primo-io/prototype-documentation/languages/brazilianportuguese.md

---
layout: default
title: Documentação protótipo Cubetto
language: Português Brasileiro
category: language
---

<br>

<div id="content" markdown="1">
##0. O que é esse documento

primo play set
Este documento reúne todas as informações necessárias para construir um protótipo do Primo.
Você pode achar mais informações sobre o projeto no site [primo.io](http://primo.io).

<h2>
<a href="#" id="translate-title">
    Como traduzir esse documento
</a>
</h2>

<div markdown="1" id="translate">

Se você gostaria de traduzir essa página para outra língua, você tem algumas opções:

1. **super fácil, sem automações** Copie e cole essa página em seu editor de texto, traduza-a e então nos envie um email para [play@primo.io](mailto:play@primo.io)

2. **fácil, um pouquinho mais automático** Crie uma conta no [GitHub](http://github.com), então abra o [repositório dessa página]https://github.com/primo-io/prototype-documentation/blob/gh-pages/index.md) e clique em 'EDIT' na barra de menus superior:

Sua página se tornará um editor de textos, onde será possível modificar a página original. A página está escrita em [markdown](http://daringfireball.net/projects/markdown/syntax), uma linguagem super fácil de entender.

Você não tem que modificar o código, apenas copie e cole em seu editor de texto local e traduza a parte textual em sua língua, sem modificar os parênteses e as partes em HTML. Salve o texto e então nos envie um email para [play@primo.io](mailto:play@primo.io)

3. **avançado, tudo automático** Essa opção é um pouco mais avançada, mas nada tão difícil assim, se você não é familiarizado com o Github essa é a chance de aprender algo novo :) <br>
Se você já conhece o Git, você deve dar um 'fork' no repositório, todas as traduções estão localizadas na pasta 'languages’. Para traduzir esse documento, apenas copie uma das páginas com a tradução inicial (“english.md” por exemplo) na mesma pasta e então mude o nome do arquivo para o nome da língua que você está traduzindo (spanish.md). Mude os valores 'title' (título na sua língua) e 'language' (a linguagem final, com Letras Maiúsculas) e depois traduza o restante do documento. Uma vez terminada a tradução, faça uma requisição pelo Git (‘pull request‘) para adicionar o seu novo arquivo à pasta original. Ele será automaticamente adicionado ao menu.<br><br>
Segue abaixo um passo-a-passo:

  1. Crie uma conta no GitHub
  2. Faça o download do aplicativo GitHub para desktop ([Mac](http://mac.github.com/), [Windows](http://windows.github.com/))
  3. Se é a primeira vez que você o utiliza, abra o programa e entre com o login e senha de sua conta no GitHub
  4. Vá para [esse repositório](https://github.com/primo-io/prototype-documentation)
  5. Clique no botão ‘Fork‘ no canto superior direito, para trabalhar em paralelo com esses arquivos dentro de sua conta.
  6. Vá para sua conta no GitHub, abra a página do repositório que você acabou de dar um ‘fork‘ e clique no botão "Clone in Desktop", na barra lateral direita. Isso fará com o que o aplicativo do GitHub abra automaticamente, perguntando onde salvar o repositório em seu disco local.
  7. Depois de selecionar um local em seu computador, clique em 'clone'
  8. Depois de fazer o download dos arquivos, entre na pasta onde os arquivos foram baixados em seu computador.
  9. Abra a pasta 'languages', onde todas as traduções estão localizadas. Selecione a língua com que você vai começar ("english.md" por exemplo), e então copie o arquivo e renomeie-o com o nome da língua de destino ("spanish.md" por exemplo), na mesma pasta.
  10. Abra o arquivo recém-criado e mude os valores 'title' (título na nova língua) e 'language' (a língua de destino em Letras Maiúsculas), então traduza o documento, mantendo a formatação markdown.
  11. Depois de terminada e salva a tradução é hora de subir o arquivo para o GitHub. Abra o aplicativo do GitHub e clique duas vezes no repositório. Na barra lateral esquerda, clique na aba "Changes". Ela deve informar "Uncommitted Changes".
  12. Dê um título à sua edição, como "spanish translation", clique em "commit" e depois no botão "sync".
  13. Vá até o seu perfil no GitHub, na página do repositório que você trabalhou em paralelo (“forked”). Você deve ser capaz de ver a nova página criada na pasta 'languages'. Na parte superior deve haver um botão verde com duas setas, clique nele para requisitar a publicação. (veja a figura abaixo)

  

  14. Clique em "Create Pull Request"
	
  

  15. Escreva uma mensagem para a sua requisição e é só isso! Agora nós apenas precisamos aprová-la.
</div>
<br>

##1. O que é o Primo

primo play set

Primo é uma interface física projetada para introduzir a lógica de programação para crianças pequenas (de 3 a 7 anos), sem a necessidade de alfabetização. O objetivo do jogo é conduzir um pequeno robô, chamado Cubetto, de volta para sua casa. Para alcançar o objetivo, as crianças devem programar o robô usando um conjunto limitado de instruções: em frente, à esquerda, à direita e função. Enquanto as primeiras três instruções são bem intuitivas, essa última chama uma sub-rotina, uma linha extra de instruções empacotadas em um único comando.

<div class="videoWrapper">
	<iframe src="//player.vimeo.com/video/82620072" frameborder="0" webkitallowfullscreen="true" mozallowfullscreen="true"  allowfullscreen="true">        
    </iframe> 
</div>

##2. Pesquisa

O ensino de programação para crianças é um campo já amplamente debatido. Nós já conhecemos algumas soluções que possuem esse mesmo objetivo, mas para crianças acima de 8 anos. Entretanto, não existem muitas soluções adaptadas para crianças mais novas e não existe nenhuma que trabalha sem a necessidade de telas e de pré-alfabetização. Vemos um número crescente de aplicativos para tablets e computadores que também trabalham em conjunto com robôs, mas nenhum deles é completamente livre do domínio do pixel como é o nosso conjunto Primo.

A madeira foi escolhida como o material principal, em primeiro lugar, porque é natural; traz uma sensação mais 'quente' e tem uma sonoridade bacana. A segunda razão é cultural. Foram realizadas pesquisas sobre brinquedos utilizados em jardins de infância tradicionais na Suíça (onde o produto foi originalmente concebido) e foi descoberto que os jogos mais queridos pelas crianças eram aqueles feito com madeira. Brinquedos de madeira são, de maneira geral, muito duráveis e você pode ver as marcas e arranhões neles, sinais de seu uso por outras crianças. É um material com memória. A madeira foi escolhida também como material por conta do forte contraste que ela cria com o uso da tecnologia. Dentro do Primo existe um circuito integrado, mas nós queríamos criar uma experiência 'mágica', escondendo propositadamente a complexidade existente no conjunto.



O conceito por detrás do Primo é muito inspirado pelo trabalho de Seymour Papert, um matemático que foi o co-fundador do Laboratório de Inteligência Artificial no MIT, juntamente com Marvin Minsky nos anos sessenta (se você está interessado nesse tema, sugerimos que você leia [Mindstorms](http://www.amazon.co.uk/Mindstorms-Children-Computers-Powerful-Ideas/dp/0465046746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), seu livro mais famoso). Ele dirigia a equipe que inventou o [LOGO](http://en.wikipedia.org/wiki/Logo_(programming_language)), provavelmente o recurso mais amplamente utilizado para o ensino de programação para crianças. O objetivo de Seymour Papert não era apenas ensinar a programar, mas também ajudar as crianças a descobrir a sua maneira pessoal de resolver problemas. Primo pode ser considerado uma grande simplificação do LOGO e da 'tartaruga', que era a sua interface física. Nós limitamos as nossas instruções à sua mais pura forma, evitando qualquer tipo de linguagem numérica ou textual.

O primeiro protótipo do Primo foi realizado no SUPSI Lugano, por Matteo Loglio (co-fundador do Primo e designer de interação), durante o [MAInD - Master of Advanced Studies in Interaction Design](http://www.maind.supsi.ch/). A formação de Matteo é em design do produto e depois de aprender o básico sobre Arduino e sua programação, suficientes para a criação do protótipo, ele começou a procurar por soluções técnicas que eram acessíveis para um novato, com o intuito de desenvolver um produto como o Primo. Existiam dois problemas principais: a execução de um carro-robô desde o zero e uma interface que pudesse reconhecer facilmente diferentes instruções.
O primeiro problema foi resolvido com o uso de uma placa [Oh_Oh board](http://david.cuartielles.com/w/Maquila2/Ohoh) de  David Cuartielles, um dos fundadores do Arduino, que havia dado uma palestra no SUPSI. O Oh_Oh robot é um projeto Open Source - de código aberto - e você pode acessar os arquivos fonte no link acima. É basicamente um Arduino em forma de carro, apenas com um Xbee adicionado para a comunicação via radio.

A segunda questão era projetar uma maneira confiável de detectar os blocos de instrução. A solução foi inspirada por um projeto do [CIID](http://ciid.dk/) chamado ["Barcode Piano"](http://ciid.dk/education/portfolio/idp11/courses/physical-computing/projects/barcode-piano/). 

<div class="videoWrapper">
	<iframe src="//player.vimeo.com/video/19704918" frameborder="0" webkitallowfullscreen="true" mozallowfullscreen="true"  allowfullscreen="true">    
    </iframe>
</div> 

A idéia era usar blocos bem simples, que poderiam ser reconhecidos pela placa usando resistores. É uma operação básica de divisão de voltagem, com os pinos analógicos do Arduino lendo os valores dos resistores. É um método bem simples mas bastante eficiente para um protótipo.

No campo do design, algumas características ainda precisavam ser testadas; o design atual é o resultado de muitas iterações.

O a escolha do formato de 'cobra' ou ‘zig-zag' para a sequência de instruções foi escolhida para evitar pré-concepções relacionadas com a alfabetização.  

left to right

O formato em 'D' dos blocos conectores foi projetado para que os mesmos pudessem ser inseridos de uma só maneira, sendo consistentes com o desenho do caminho e com a direção a ser seguida pelo carro. Múltiplos designs poderiam ser usados para isso. O formato em D foi escolhido pois é basicamente 'um circulo com orientação' e também porque de certa maneira remete a um quadro de avisos, um objeto familiar.

instruction blocks

O desenho do formato dos blocos de instrução ainda está sendo testado. O design atual funciona bem, as crianças pegam facilmente o significado. Eles apenas tem alguma dificuldade inicial para se familiarizarem com os blocos de comando ‘direita' e ‘esquerda’. Isso ocorre também porque, em geral, esses conceitos de direção também são novos para os pequenos. Continuamos testando outros formatos de blocos para aprimorar ainda mais essa questão.

<div class="videoWrapper">
	<iframe src="//player.vimeo.com/video/50570097" frameborder="0" webkitallowfullscreen="true" mozallowfullscreen="true"  allowfullscreen="true">
        
    </iframe>
</div>

No início, o robô tinha a forma de um carrinho de brinquedo e era uma forma bem complicada, que consumia um tempo enorme para ser produzida, pois era toda cortada à laser, colada camada por camada e depois lixada por mais de uma hora. O carro também continha um outro problema, que era ser muito orientado para meninos. Queríamos evitar a discussão com os produtores de brinquedos educativos e sermos criticados por fazermos apenas brinquedos para meninos. Queríamos nos manter neutros e não criar um brinquedo específico para meninos ou meninas, então optamos por uma geometria super neutra, uma caixa.

Demos um nome para a caixinha, junto com uma carinha sorridente, fazendo-o mais chamativo para as crianças. O robô foi chamado de Cubetto (cubinho em italiano). A idéia com o Cubetto é também criar um módulo básico que pode ser expandido e customizado facilmente no futuro.

cubetto

##3. Começando

###3.1 O básico

Primo é composto por três partes: a Mesa de Interface, o Cubetto e um conjunto de Blocos de Instrução. As crianças interagem com a Mesa colocando os Blocos de Instrução nos orifícios para criar uma seqüência (Um programa) que o Cubetto vai executar.

Existem quatro tipos de Blocos de Instrução, o que significa que resistores com 4 valores distintos podem ser usados, preferencialmente com valores distantes uns dos outros.

Os Blocos são inseridos nos orifícios da Mesa de Interface, onde o valor do resistor é identificado. Depois disso, os valores são processados em uma ‘fila’, que é enviada ao Cubetto usando dois módulos Xbee. Então o Cubetto executa as instruções, uma após a outra.

O cérebro do protótipo é feito com duas placas Arduino, uma UNO (uma Leonardo ou uma Duemilanove também funcionam) para o Cubetto e uma Mega para a Mesa de Interface, onde são necessárias 16 entradas analógicas.

###3.2 Eletrônica

###Ferramentas Necessárias

* Ferro de solda
* Solda
* Fios
* Pistola de cola quente
* Cola de madeira
* Fita de cobre com 5mm de largura

###Materiais (preços em euro)

Cubetto ~ 88 €

* Arduino UNO (ou Leonardo) - 20 € : [Arduino Store](http://store.arduino.cc/index.php?main_page=product_info&cPath=11&products_id=195#.UxC5nfTV_bA)
* Módulo Arduino Proto Wireless Shield - 14.90 € : [Arduino Store](http://store.arduino.cc/index.php?main_page=product_info&cPath=37_5&products_id=145#.UxC53vTV_bA)
* Driver para Motor SN754410 - 3.90 € : [Arduino Store](http://store.arduino.cc/index.php?main_page=product_info&cPath=6_33&products_id=153#.UxC5-_TV_bB)
* XBee (série 1 ou 2, não faz diferença) : 23.90 € - [Arduino Store](http://store.arduino.cc/index.php?main_page=product_info&cPath=37_38&products_id=292#.UxC6cvTV_bA)
* Rodas SolarBotics  x 2 : 4.74 € - [Solarbotics Store](https://solarbotics.com/product/gmpw/)
* Motores GM3 SolarBotics x 2 : 8.36 € - [Solarbotics Store](https://solarbotics.com/product/gm3/)
* 2 rodizios de metal : 5.79 € - [Solarbotics Store](https://solarbotics.com/product/23160/)
* Interruptor óptico refletivo CNY70 x 2 : 1 € - [Mouser](http://uk.mouser.com/ProductDetail/Vishay/CNY70/?qs=%2fha2pyFaduj8YpDhNNtXszq4w32cl%2fAjUjdOwQUvJUM%3d)
* (opcional) Suporte de bateria : 4 € - [Solarbotics Store](https://solarbotics.com/product/bholdaa_4_cell/)
* (opcional) 4 x Baterias recarregáveis

Mesa de Interface ~ 88 € (pura coincidência)

* Arduino Mega 2560 : 39.00 € - [Arduino Store](http://store.arduino.cc/index.php?main_page=product_info&cPath=11&products_id=196#.UxC_gPTV_bA)
* Módulo Arduino Proto Wireless Shield : 14.90 - [Arduino Store](http://store.arduino.cc/index.php?main_page=product_info&cPath=37_5&products_id=145#.UxC53vTV_bA)
* XBee (série 1 ou 2, não faz diferença) : 23.90 € - [Arduino Store](http://store.arduino.cc/index.php?main_page=product_info&cPath=37_38&products_id=292#.UxC6cvTV_bA)
* 16 LEDs 5mm Vermelho : 1 € - [Mouser](http://uk.mouser.com/ProductDetail/Lite-On/LTL-4223/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)
* 16 Resistores 220 Ω  : 0.16 € - [Mouser](http://uk.mouser.com/ProductDetail/Xicon/291-220-RC/?qs=sGAEpiMZZMu61qfTUdNhG%2f1uGo5nxyCVqn6ChOCvUEE%3d)
* 16 Resistores 10K Ω : 0.16 € - [Mouser](http://uk.mouser.com/ProductDetail/Xicon/291-10K-RC/?qs=sGAEpiMZZMu61qfTUdNhG6xwTrVwTvbz8PPav3aExs8%3d)
* 1 Chave tipo Push Button NA sem trava : 1 € 
* 50 Conectores macho simples : 1 € 
* 16 Conectores macho duplos : 0.50 € - [Arduino Store](http://store.arduino.cc/index.php?main_page=product_info&cPath=6_32&products_id=294#.UxC_3fTV_bA)
* 50 Conectores fêmea : 1 € - [Arduino Store](http://store.arduino.cc/index.php?main_page=product_info&cPath=6_32&products_id=188#.UxDAAfTV_bA)
* 16 Imãs ø 4 h 3 : 3.5 € - [Supermagnete](http://www.supermagnete.ch/eng/S-04-03-N)

Blocos de Instrução ~ 4 €

* 4 x Resistor 4.7K Ω : 0.04 € - [Mouser](http://uk.mouser.com/ProductDetail/Xicon/291-47K-RC/?qs=sGAEpiMZZMu61qfTUdNhG%2fbdyz6pU6a%252bvHlD5kaZWgo%3d)
* 4 x Resistor 100K Ω : 0.04 € - [Mouser](http://uk.mouser.com/ProductDetail/Xicon/291-100K-RC/?qs=sGAEpiMZZMu61qfTUdNhG81NIhcRRUJQxII5Nsctha8%3d)
* 4 x Resistor 220 Ω : 0.04 € - [Mouser](http://uk.mouser.com/ProductDetail/Xicon/291-220-RC/?qs=sGAEpiMZZMu61qfTUdNhG%2f1uGo5nxyCVqn6ChOCvUEE%3d)
* 4 x Resistor 10K Ω : 0.04 € - [Mouser](http://uk.mouser.com/ProductDetail/Xicon/291-10K-RC/?qs=sGAEpiMZZMu61qfTUdNhG6xwTrVwTvbz8PPav3aExs8%3d)
* 16 Imãs ø 4 h 3 : 3.5 € - [Supermagnete](http://www.supermagnete.ch/eng/S-04-03-N)

###3.3 Energia

O Cubetto e (opcionalmente) a Mesa de Interface, são alimentados à bateria. Para o protótipo você pode usar uma bateria LiPo (Lítio-Polímero) ou pilhas AA normais, fica a seu critério. Nós já usamos ambas, as baterias LiPo são boas, mas você precisará de equipamento extra. Se você está começando o seu protótipo do zero, recomendamos as pilhas AA. Apenas lembre-se que elas acabam muito rápido, então o melhor seria usar as pilhas recarregáveis, como as de NiMh.

###3.4 Projeto do Protótipo

Todo o produto é feito com madeira cortada a laser, com espessuras de 4mm (a maioria) e de 1mm (apenas uma camada). Você pode cortar essas partes usando serviços de terceiros, como a Ponoko, ou no seu Fab Lab local. O primeiro protótipo foi cortado dentro do [FabLab Lugano](http://fablab.supsi.ch/), enquanto que o produto já desenvolvido foi feito no [FabLab Torino](http://fablabtorino.org/), onde parte da equipe de desenvolvimento do Primo ainda reside.

Construir o Cubetto e a Mesa de Interface é um procedimento trabalhoso, mas muito simples, pois suas superficies são basicamente caixas. O trabalho mais complexo está nos Blocos de Instrução. Eles são um sanduíche de duas camadas de 4mm de madeira com imãs e resistores soldados internamente.

##4. Fazendo o Protótipo

###[Download dos arquivos fonte](files/primo-prototype-laser.zip)

###4.1 Mesa de Interface

Para fazer a mesa de Interface você tem que cortar a laser esses dois arquivos: interface-board-4mm.dxf e interface-board-1mm.dxf: o primeiro é para a madeira tipo compensado de 4mm e o segundo para o de 1mm. Como você pode ver nos arquivos, as partes estão todas numeradas para facilitar o processo de montagem. Os números foram desenhados em uma camada diferente, para que você possa removê-los facilmente antes do corte a laser. Nós recomendamos que você faça o ajuste do orifício para o interruptor do tipo push-button baseado no modelo que você encontrou ou no que já tenha.

Em primeiro lugar, você tem que colar entre si as partes 3 e 4, usando os furos nos cantos para alinhá-las com parafusos enquanto as cola. Depois, deixe-as descansando por uma noite.

Pegue então a fita de cobre, corte 32 pedaços com 70mm cada e passe-os dentro dos orifícios retangulares das partes que você acabou de colar, deixando ao menos 30mm de cada lado (em cima e em baixo). 

copper connectors
copper connectors

Uma vez terminado esse trabalho você pode colar as partes já anteriormente coladas, nessa ordem:1+2 com 3+4.

copper connectors

Assim que a cola secar, chegou a hora de colocar os imãs. Vire a camada superior da Mesa para baixo e preencha os pequenos orifícios com os imãs, tendo certeza de que eles estão sempre na mesma polaridade/direção, não importa se norte ou sul. Sele os buraquinhos com uma gota de cola quente.

Agora, a eletrônica! Comece fazendo as trilhas para a alimentação (5V, vermelho) e para o aterramento (GND, preto) em toda a extensão da fila de orifícios, como mostrado na figura. Fizemos o nosso primeiro protótipo sem a fita de cobre, mas usando fios (que você também pode usar), mas nesse protótipo nós preferimos usar a fita, mesmo para as trilhas. Ela deixa o trabalho de montar as conexões muito mais fácil depois.

rails

O próximo passo é conectar um dos dois conectores de cada orifício à trilha GND. Se você usou a fita de cobre, pode agora usar um pequeno pedaço extra, suficiente apenas para tocar as duas extremidades.

rails

Agora temos que juntar os outros conectores restantes com a trilha de alimentação (5V), mas dessa vez com um resistor de 10KΩ entre eles. Uma característica bacana da fita de cobre é que a solda gruda muito bem em sua superfície. Essa é a técnica usada:

10k

No final desse processo, você deve ter algo assim:

10k scheme

Agora é a hora de colocarmos os LEDs; Espete um LED vermelho em cada um dos 16 orifícios, então use uma gota de cola quente para fixá-los na madeira. Uma vez que a cola esfriou, é a hora de conectá-los. Lembre-se que os LEDs possuem polaridade: a perna mais comprida é o ânodo e a mais curta o cátodo. 

10k

Conecte cada cátodo com a trilha do aterramento (GND), usando um resistor de 220Ω.

10k scheme

A perna mais comprida do LED deve ser conectada a um pino de entrada/saída (I/O) digital no Arduino Mega. Esses pinos são numerados de 22 a 53. Os LEDs devem ser conectados numa ordem sequencial, assim será muito mais fácil acessá-los mais tarde durante a programação. No meu protótipo, por exemplo, comecei no pino de número 30 e fui até o 45 (são 16 LEDs).
O ponto de partida não é importante, desde que eles estejam na ordem sequencial correta. Isso significa, por exemplo, que se começarmos do pino 30, o primeiro LED deve estar conectado no pino 30, o segundo no pino 31, o terceiro no pino 32 e assim por diante, até o LED 16 no pino 45.

Os cabos devem ser soldados em uma barra de pinos conectores machos duplos, pois os pinos de entrada e saída no Arduino Mega são dispostos em uma linha dupla. Desta maneira fica mais fácil de remover o Arduino da Mesa de Interface quando for necessário.

rack

Uma vez que todos os LEDs estejam soldados, nós temos que começar a soldar os conectores da Mesa, àqueles feitos à mão com a fita de cobre. Esses devem ser ligados aos pinos analógicos do Arduino através de um cabo para que seja possível fazer a leitura dos diferentes valores dos resistores. Assim como no caso dos LEDs, esses também dever ser conectados em ordem, começando do A0 para o orifício 1 até o A15 para o orifício 16. O cabo deve ter início do mesmo ponto onde soldamos previamente os resistores de 10K. Veja a imagem:

analog input board connections

<div class="cf">


<p>
Aqui eu usei alguns conectores macho simples, já que os pinos de entrada e saída analógicos estão dispostos em apenas uma fileira.
	
</p>

<p>
A última coisa a ser conectada é o botão do tipo push-button: solde dois cabos em seus dois conectores, então passe-os pelo seu respectivo orifício na Mesa de Interface, a partir da face superior, puxando-os para baixo até que o botão se encaixe direitinho. Agora vire a Mesa e você deve ter os dois cabos que acabou de soldar saindo pelo orifício. Conecte-os como na figura: um vai direto para a alimentação 5V e o outro para o aterramento (GND) usando um resistor de 10K. Então, conecte-o a um pino de entrada/saída digital no Arduino, a partir de uma extremidade do resistor. Neste exemplo nós usamos o pino de número 50.
</p>
</div>



A Mesa já está quase pronta, agora só falta conectar o módulo wireless na parte superior do Arduino Mega e plugar os conectores em seu lugar na placa. Recapitulando: pinos 30 a 45 para os LEDs, A0 ao A15 para os conectores e o número 50 para o botão push-button. Use os pinos de A0 a A5 no módulo wireless para os primeiros 5 conectores. Não se esqueça de conectar a trilha do aterramento (GND) ao pino GND e a trilha de alimentação (5V) no pino 5V.

rack

Agora um ajuste fino: depois de pintar a parte 12 da Mesa, você pode colá-la com a parte 13 no topo da mesma.

O mesmo vale para o botão vermelho: depois de pintar a parte 14, coloque algo macio, como um papel cartão ou EVA no topo da parte 2, ao redor do botão push-button e, antes que a cola seque, cole o botão vermelho. Veja na figura:



###BLOCOS DE INSTRUÇÃO

Este é um bloco de instrução, em vista explodida:



Para fazer os Blocos de Instrução, a primeira coisa que você deve providenciar é o corte a laser dos respectivos arquivos; existe um para a madeira de 4mm e um para a de 1mm. São quatro camadas, numeradas de 1 a 4 e os desenhos fornecidos serão usados para fazer 16 blocos, quatro de cada tipo.

Cada bloco possui um resistor diferente. Esses são os valores dos resistores usados no protótipo:

FRENTE: 4.7K Ω<br>
ESQUERDA: 100K Ω<br>
DIREITA: 220 Ω<br>
FUNÇÃO: 10K Ω

Para fazer os blocos, primeiro você tem que colar a parte 4 com a parte 3.

Após a cola ter secado, você pode começar a pintar. Veja a figura abaixo para entender o esquema das cores:



Agora você tem que cortar dois pedaços de fita de cobre com 40mm de comprimento. Passe os mesmos pelos orifícios das duas peças que você acabou de colar e forme um anel bem apertado em volta delas.



Depois disso você deve inserir os imãs dentro dos orifícios. Enquanto faz isso, TENHA CERTEZA QUE OS MESMOS ESTÃO CORRETAMENTE ORIENTADOS, para que os blocos de fato ’grudem’ na Mesa. Se você fizer de maneira contrária os mesmos serão repelidos, o que é até engraçado, mas não é o que queremos, certo?

Fixe o imã com uma gota de cola quente e, antes da cola esfriar, coloque o resistor correspondente no topo, com as ‘pernas' sobre a fita de cobre. Depois disso, o resistor precisa ser soldado nessas duas partes. Depois de soldar, corte a parte que sobrou e cole a parte 2 no topo do resistor.

Termine seu bloco colando a última camada, a parte número 1, no topo, e repita todo o processo para cada Bloco de Instrução :)

###CUBETTO

Eletrônica:

O protótipo do Cubetto pode ser construído usando um Arduino Uno ou Leonardo, com um Módulo Wireless agregado. A razão do uso desse tipo de módulo é que ele tem uma superfície relativamente pequena, mas que é suficiente para colocarmos os drivers dos motores, os conectores para os codificadores ópticos, os motores e a alimentação. 

O Cubetto deve girar 90 graus para a esquerda e para a direita. Uma maneira não muito precisa de fazer isso seria usando uma contagem de tempo, fazendo algo como “gire a direita por um segundo”. É de se esperar que o resultado seja mais ou menos sempre o mesmo. “Mais ou menos” porque isso vai depender de uma porção de fatores distintos, como o piso, a carga da bateria e assim por diante. A maneira que resolvemos esse problema é detectando a quantidade de rotação da roda usando dois sensores ópticos CNY70 combinados com um adesivo. O adesivo redondo é aplicado por dentro da roda, como nessa foto:



O adesivo tem um padrão geométrico de listas pretas e brancas, porque o CNY70 é capaz de detectar a variação da emissão de entre elas. Dentro deles, basicamente existe um LED infravermelho - sempre ligado - e um fototransistor que faz a leitura da quantidade de luz infravermelha. Quando o material preto está na frente do componente quase não há luz refletida, já que a cor preta tende a absorvê-la. No caso oposto, quando o material é branco, ele reflete toda a luz, logo o valor lido pelo sensor é muito grande. A diferença entre essas leituras é usada para controlar a quantidade de rotação.



A área útil disponível no Módulo Wireless é onde os drivers dos motores e outros conectores das demais peças serão soldados. 



Para esse protótipo, use os pinos conectores machos simples, que receberão os conectores fêmeas na outra parte.





O driver de motor SN754410 possui 16 pinos, que devem ser conectados seguindo esse esquema:



O CNY70 esquema:



Design:

Começe cortando a laser o arquivo cubetto.dxf; Todas as partes do Cubetto são feitas com compensado de 4mm. Siga essas instruções para montar a base:



Ainda não monte os motores, você precisa primeiro montar os rodízios de metal!





Agora vamos cuidar do CNY70. Solde os dois conectores opostos, que devem ser ligados à alimentação 5V, juntamente através de um mesmo fio; então solde mais três fios nos conectores restantes do CNY70. No final desses fios, solde um bloco de três conectores fêmeas. Eles serão conectados mais tarde aos seus pares no Módulo Wireless.

Os dois CNY70 devem ser colocados na beirada da camada inferior, com o LED e o fototransistor alinhados horizontalmente. Para fixá-los você pode usar um pouco de cola quente, ou de qualquer outro tipo de cola.

Veja a figura para entender bem a posição.



Assim como nos CNY70, solde dois cabos às pequenas abas que saem de cada motor. Você pode torcer os dois cabos para fazê-los ficar um pouco mais resistentes e então, no final, solde um bloco de dois conectores fêmeas, como você pode ver na figura.

Agora imprima o desenho com as listas pretas e brancas e cole-o em um pedaço de cartolina (ou numa madeira fina também cortada a laser, fica a seu critério). Corte o perímetro e faça um furo bem no meio, pois ele será inserido entre o motor e a roda. As listas pretas e brancas devem estar viradas para o lado de dentro do Cubetto e a distância entre elas e o sensor CNY70 deve ser algo em torno de 1 a 3mm, para que o CNY70 funcione corretamente.



Agora você pode colocar as rodas sobre os motores e, se você utilizou as rodas da Solarbotics, pode aparafusá-las com o parafuso fornecido, mas não aperte muito, ok?

Cole três das quatro ‘paredes' do Cubetto, as partes 5, 7 e 8. Vamos deixar a parte de trás removível, caso queiramos modificar algo mais para a frente.

Pegue o suporte das baterias e solde os cabos preto e vermelho a outros dois conectores fêmea. Os conectores no Módulo serão ligados ao VIN e ao aterramento. Sugerimos a instalação de uma chave (interruptor) que interrompa o fio vermelho.



Agora você pode colocar o conjunto Arduino + Módulo Wireless por cima dos motores, plugar todos os conectores na placa e no Módulo e você terminou de fazer o Cubetto!
</div>

##Arduino

###[Download dos arquivos Arduino](https://github.com/primo-io/arduino-sketches/raw/master/primo-prototype-arduino.zip)

As instruções estão contidas nos próprios comentários dentro do código de programação (Sketch).
