primo-io/prototype-documentation/files/map.png

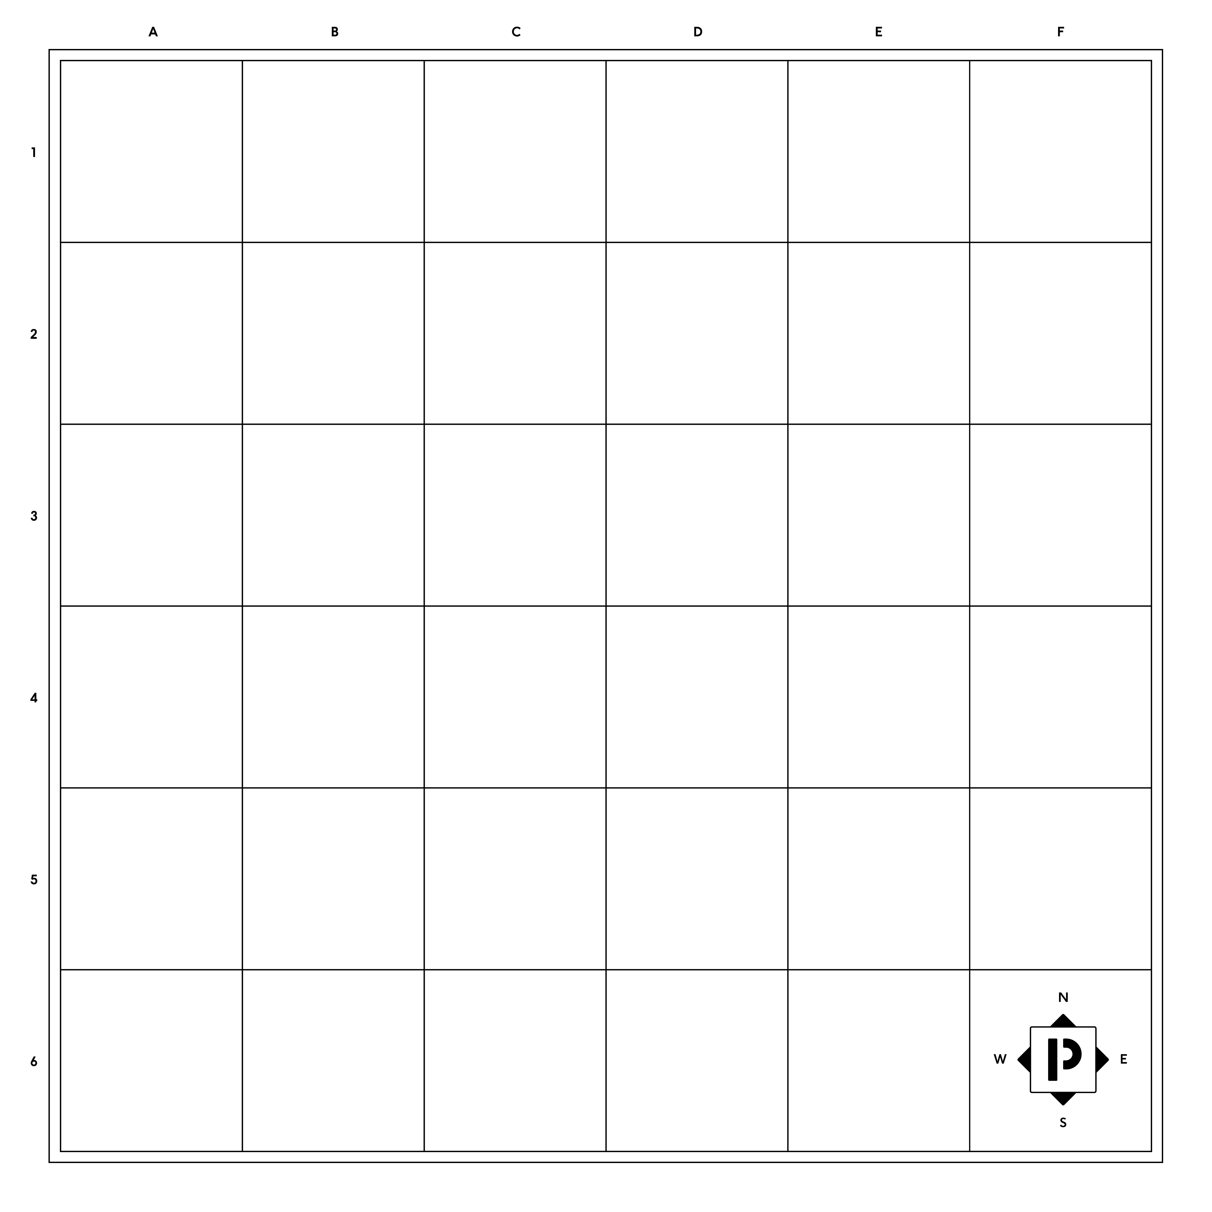
files/map.png
