primo-io/prototype-documentation/images/assets/kitemark.png

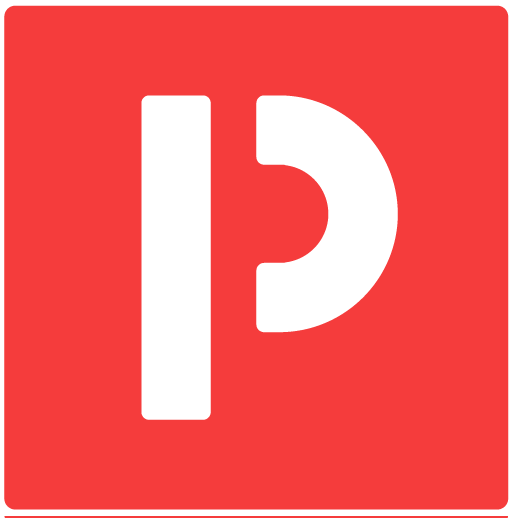
images/assets/kitemark.png
