primo-io/prototype-documentation/images/illustrations/arduino-mega.jpg

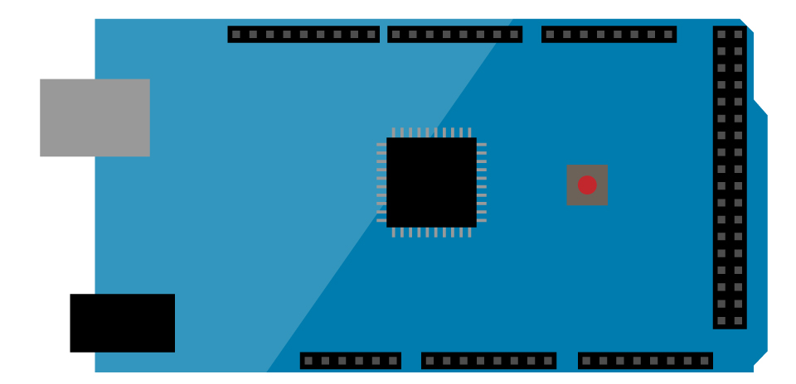
images/illustrations/arduino-mega.jpg
