primo-io/prototype-documentation/images/illustrations/board-9.jpg

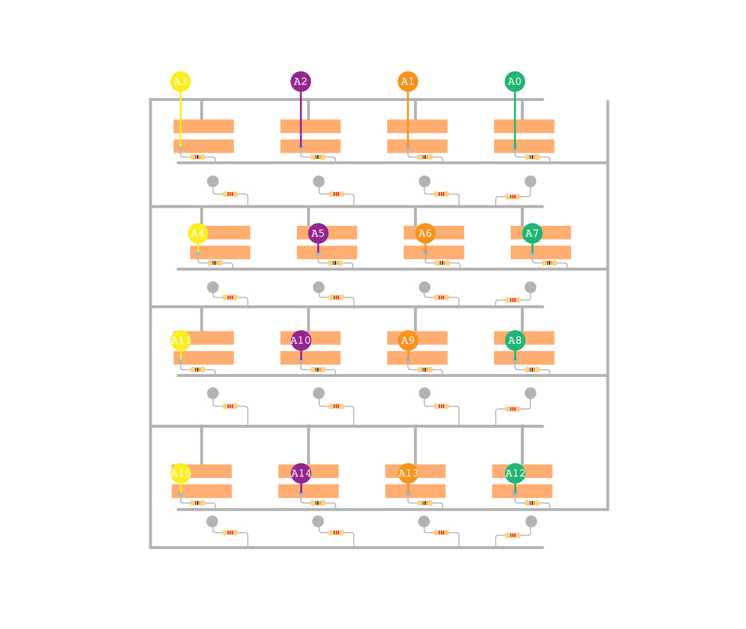
images/illustrations/board-9.jpg
