primo-io/prototype-documentation/images/illustrations/board-button-mechanics.jpg

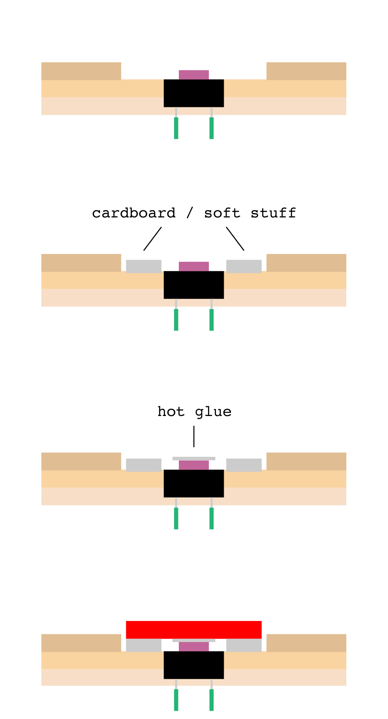
images/illustrations/board-button-mechanics.jpg
