primo-io/prototype-documentation/images/illustrations/board-button.jpg

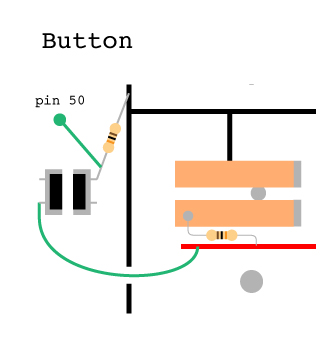
images/illustrations/board-button.jpg
