primo-io/prototype-documentation/images/illustrations/cny70-header.jpg

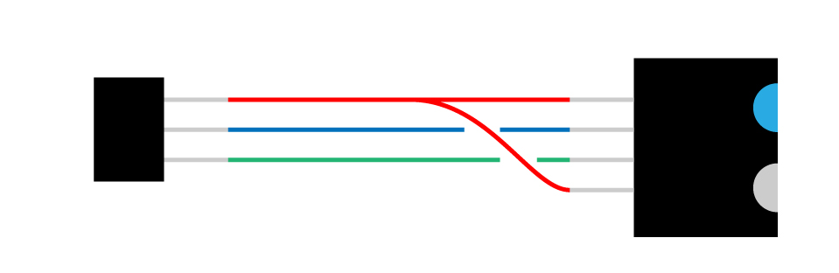
images/illustrations/cny70-header.jpg
