primo-io/prototype-documentation/images/illustrations/colour-blue.jpg

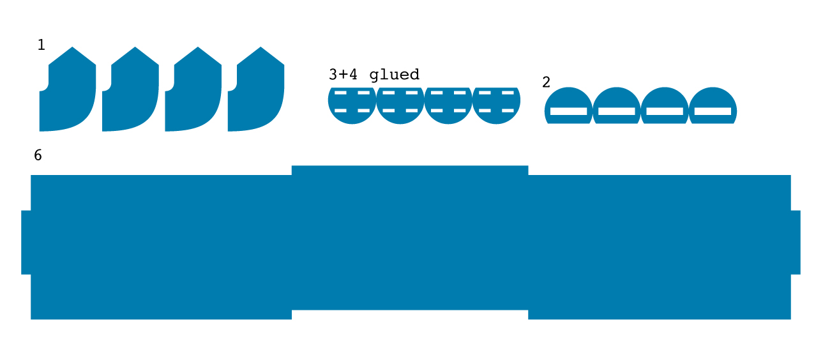
images/illustrations/colour-blue.jpg
