primo-io/prototype-documentation/images/illustrations/colour-green.jpg

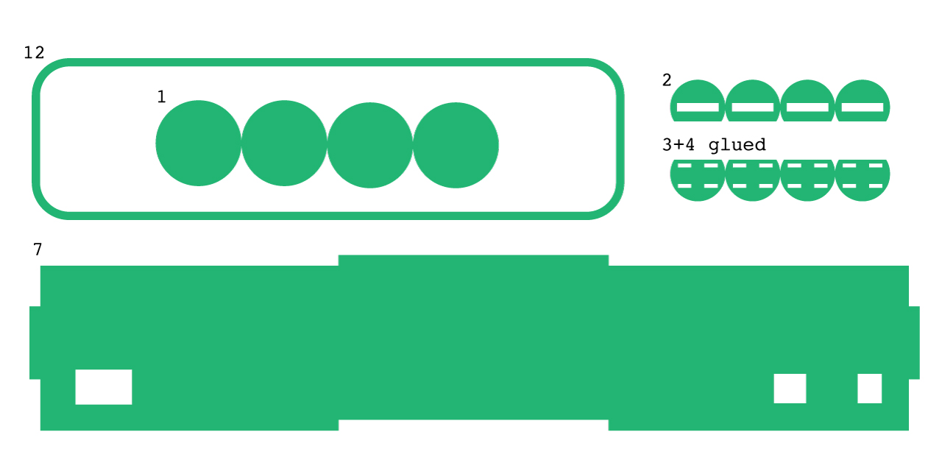
images/illustrations/colour-green.jpg
