primo-io/prototype-documentation/images/illustrations/colour-red.jpg

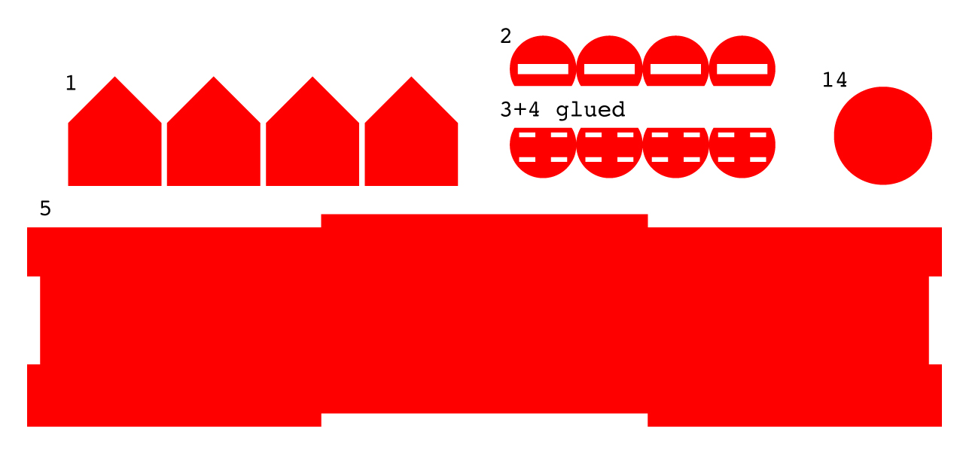
images/illustrations/colour-red.jpg
