primo-io/prototype-documentation/images/illustrations/colour-yellow.jpg

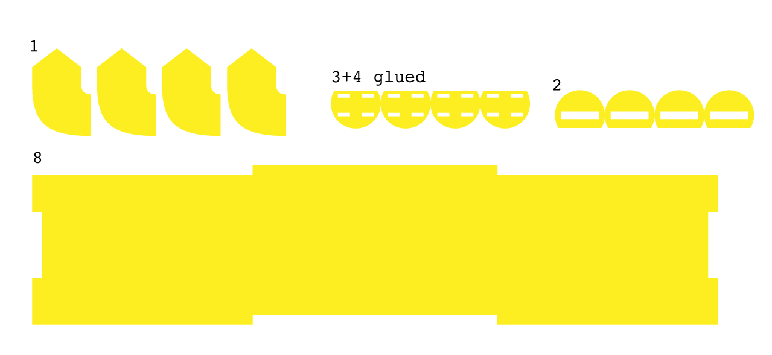
images/illustrations/colour-yellow.jpg
