primo-io/prototype-documentation/images/illustrations/cubetto-esploso.jpg

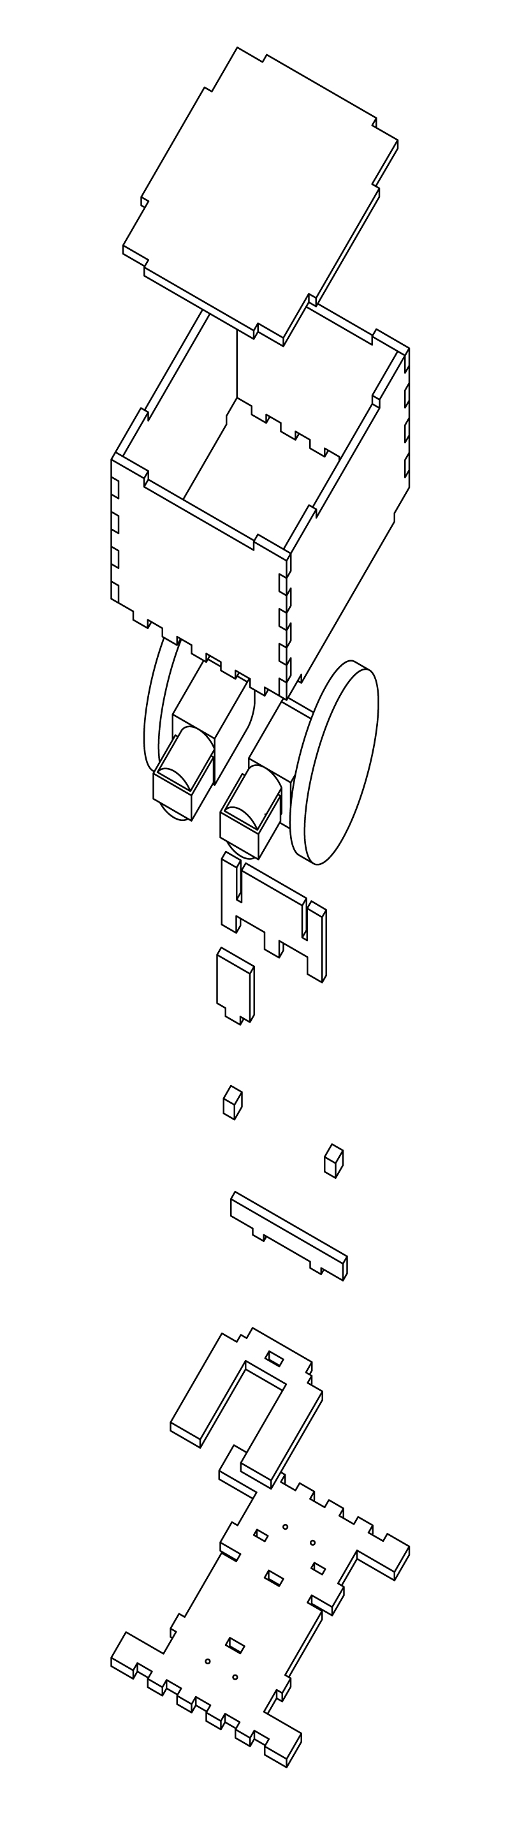
images/illustrations/cubetto-esploso.jpg
