primo-io/prototype-documentation/images/illustrations/wireless-shield.jpg

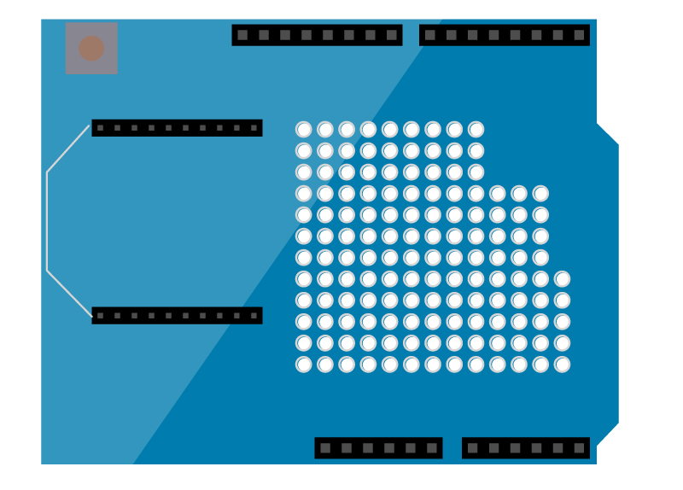
images/illustrations/wireless-shield.jpg
