primo-io/prototype-documentation/images/photo/diy-docs-2.jpg

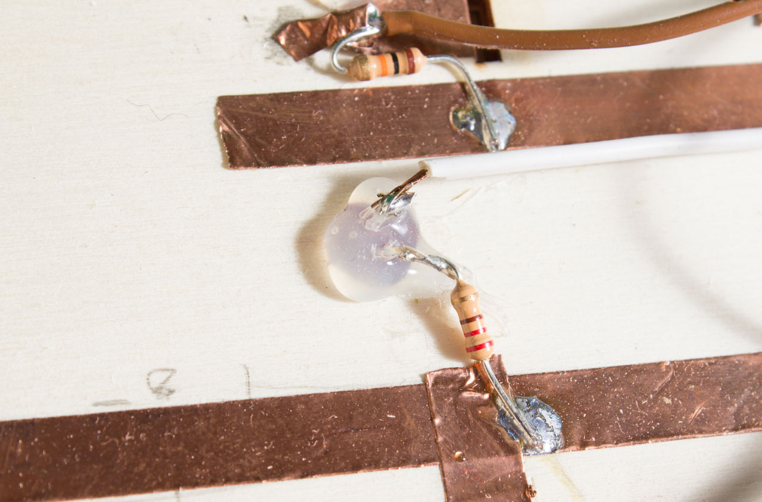
images/photo/diy-docs-2.jpg
