primo-io/prototype-documentation/images/photo/diy-docs-7.jpg

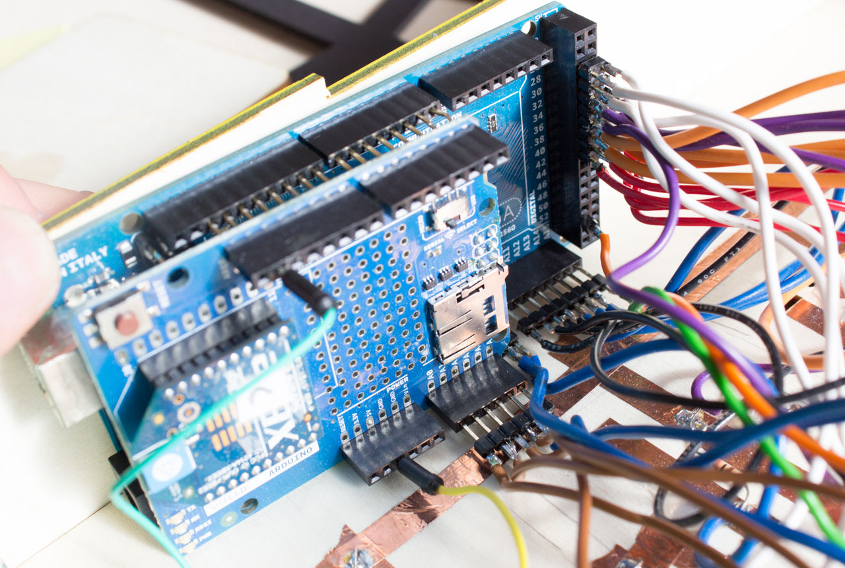
images/photo/diy-docs-7.jpg
