primo-io/prototype-documentation/images/photo/diy-docs-8.jpg

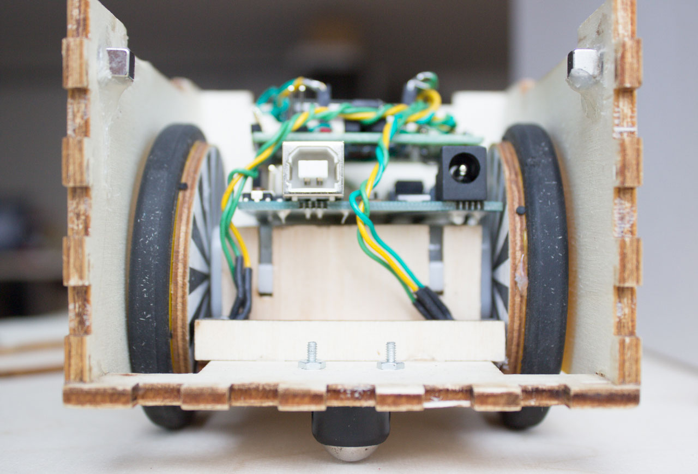
images/photo/diy-docs-8.jpg
