primo-io/prototype-documentation/files/laser-cut/house-3mm.dxf

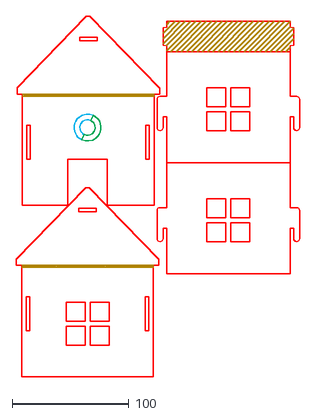
[picture p56: CAD file, 2015-08-06]
files/laser-cut/house-3mm.dxf
242.7 x 308.5
