primo-io/prototype-documentation/files/laser-cut/cubetto-4mm.dxf

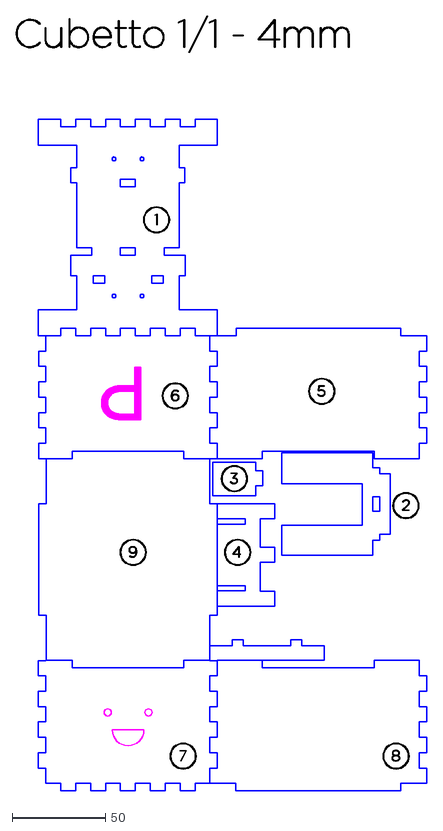
[picture p57: CAD file, 2014-04-10]
files/laser-cut/cubetto-4mm.dxf
220.2 x 415.9
