primo-io/prototype-documentation/files/laser-cut/tree-4mm.dxf

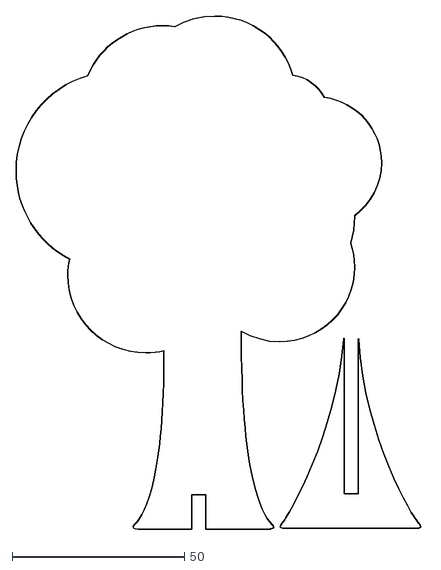
[picture p58: CAD file, 2014-03-03]
files/laser-cut/tree-4mm.dxf
118.7 x 149.3
