primo-io/prototype-documentation/files/laser-cut/fence-4mm.dxf

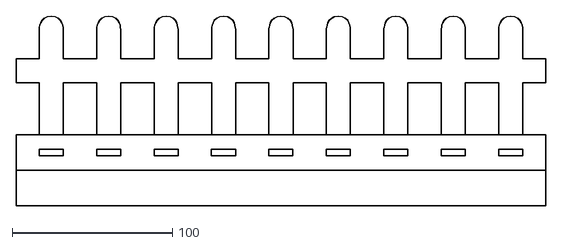
[picture p59: CAD file, 2014-03-03]
files/laser-cut/fence-4mm.dxf
330.0 x 118.1
