primo-io/prototype-documentation/files/laser-cut/instruction-blocks-1mm.dxf

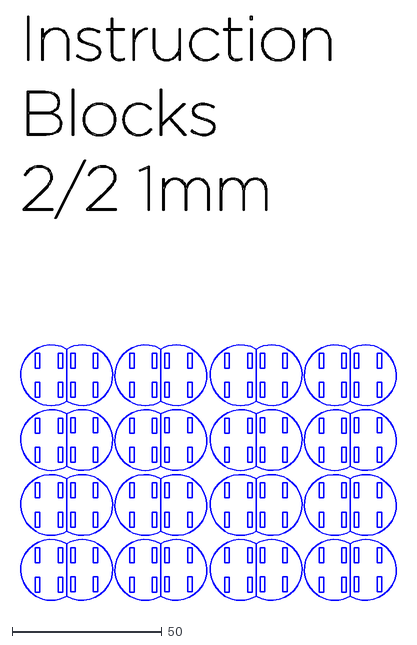
[picture p60: CAD file, 2014-02-28]
files/laser-cut/instruction-blocks-1mm.dxf
128.2 x 196.3
