primo-io/prototype-documentation/files/laser-cut/instruction-blocks-4mm.dxf

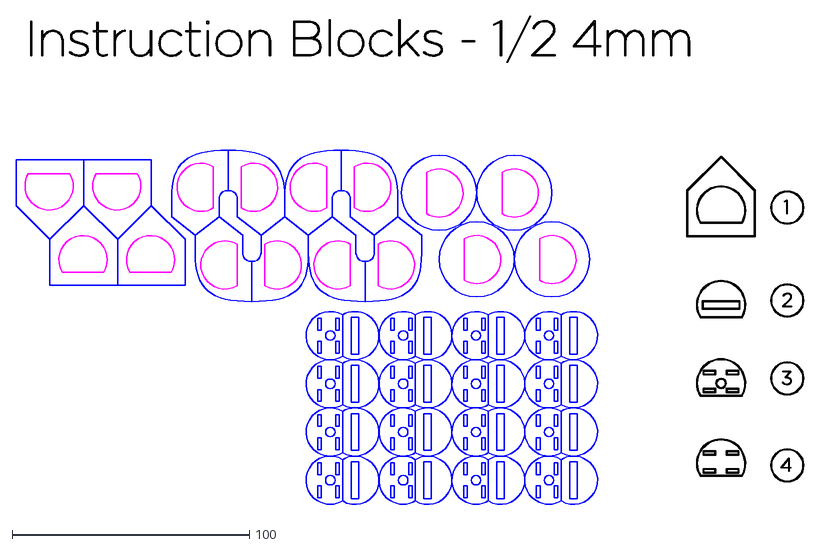
[picture p61: CAD file, 2014-02-28]
files/laser-cut/instruction-blocks-4mm.dxf
332.0 x 207.2
