primo-io/prototype-documentation/files/laser-cut/interface-board-1mm.dxf

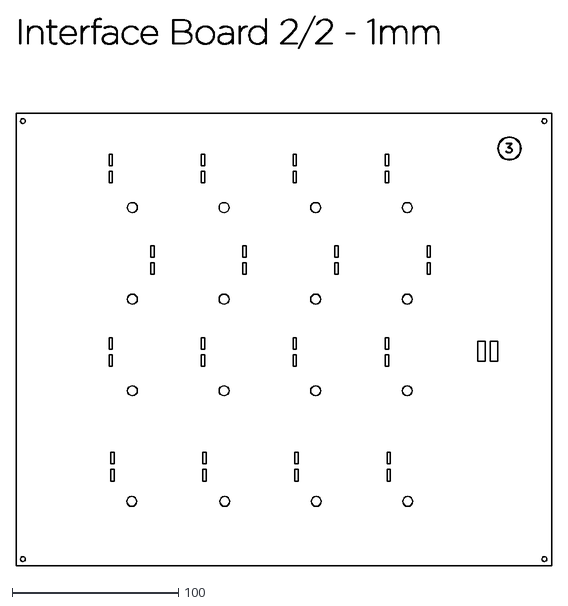
[picture p62: CAD file, 2014-02-28]
files/laser-cut/interface-board-1mm.dxf
322.1 x 330.4
