primo-io/prototype-documentation/files/laser-cut/interface-board-4mm.dxf

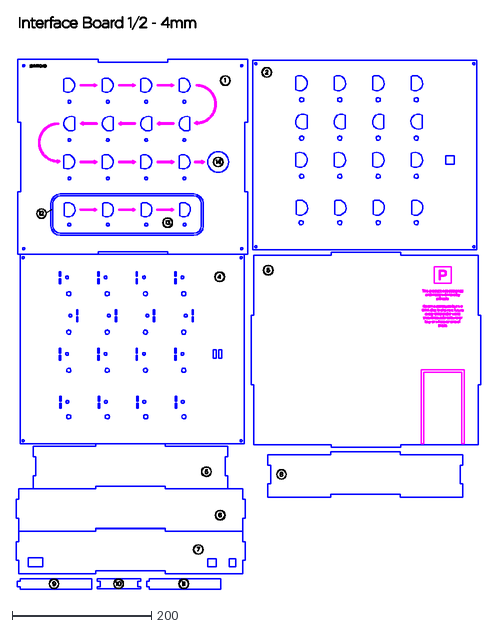
[picture p63: CAD file, 2014-02-28]
files/laser-cut/interface-board-4mm.dxf
667.8 x 823.7
