primo-io/prototype-documentation/derivatives/howto/images/rubber.jpg

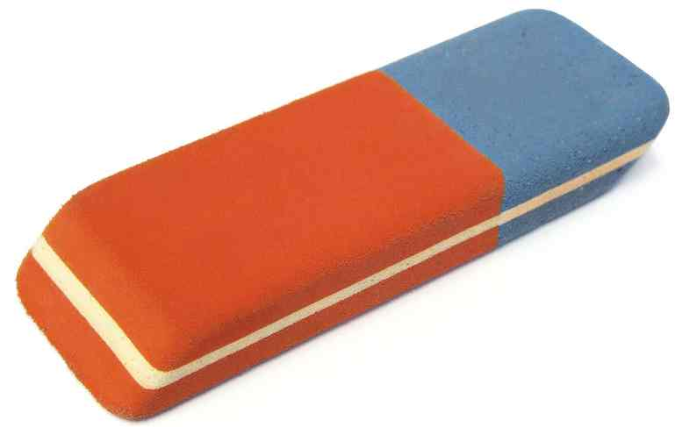
derivatives/howto/images/rubber.jpg
