primo-io/prototype-documentation/images/illustrations/motor-wiring.jpg

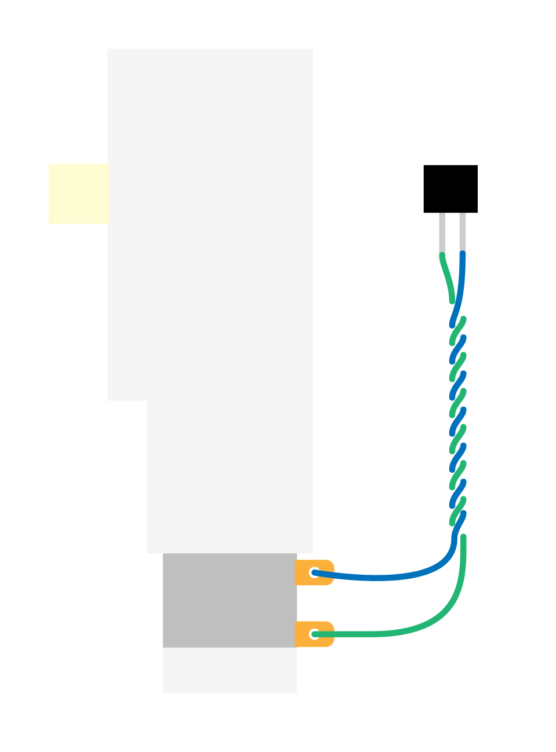
images/illustrations/motor-wiring.jpg
