primo-io/prototype-documentation/files/wheel-sticker/slices.pdf

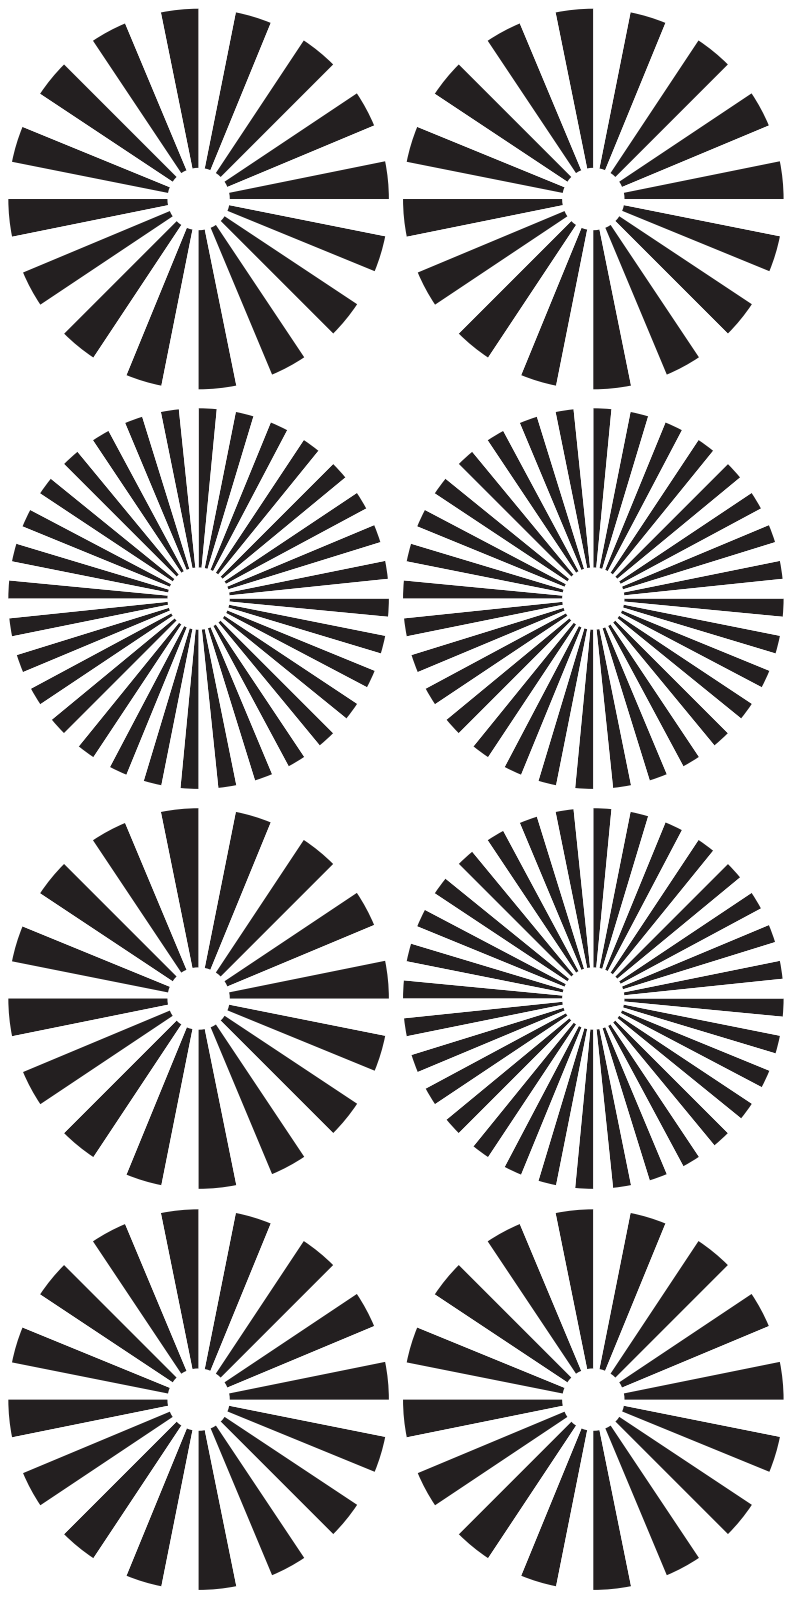
[picture p66: page 1]
