primo-io/prototype-documentation/(commit log)

2014-02-28 added source files and notes
    [cubetto-4mm.dxf, instruction-blocks-1mm.dxf, instruction-blocks-4mm.dxf, interface-board-1mm.dxf, interface-board-4mm.dxf]
2014-03-03 added fence, tree and wheel slice sticker.
    [fence-4mm.dxf, tree-4mm.dxf]
2014-03-04 switched from redcarpet to maruku, hid translating instructions, added jquery
2014-03-04 switched from maruku to kramdown (still testing) then changed base url to docs.primo.io
2014-03-07 added Arduino code, edit page structure and a bit of css
2014-04-10 Issue #13 - cubetto bottom plate holes are now 4mm
    [cubetto-4mm.dxf]
2014-07-07 French translation
    Translation in french of the Primo Prototype Documentation
2015-02-05 fixed derivatives edit button
2015-08-06 added house
    [house-3mm.dxf]
